adafruit/Adafruit-MAX98357-I2S-Amp-Breakout/Adafruit MAX98357 Breakout - Stereo rev B.brd

## EAGLE design Adafruit MAX98357 Breakout - Stereo rev B.brd (2026-08-27)

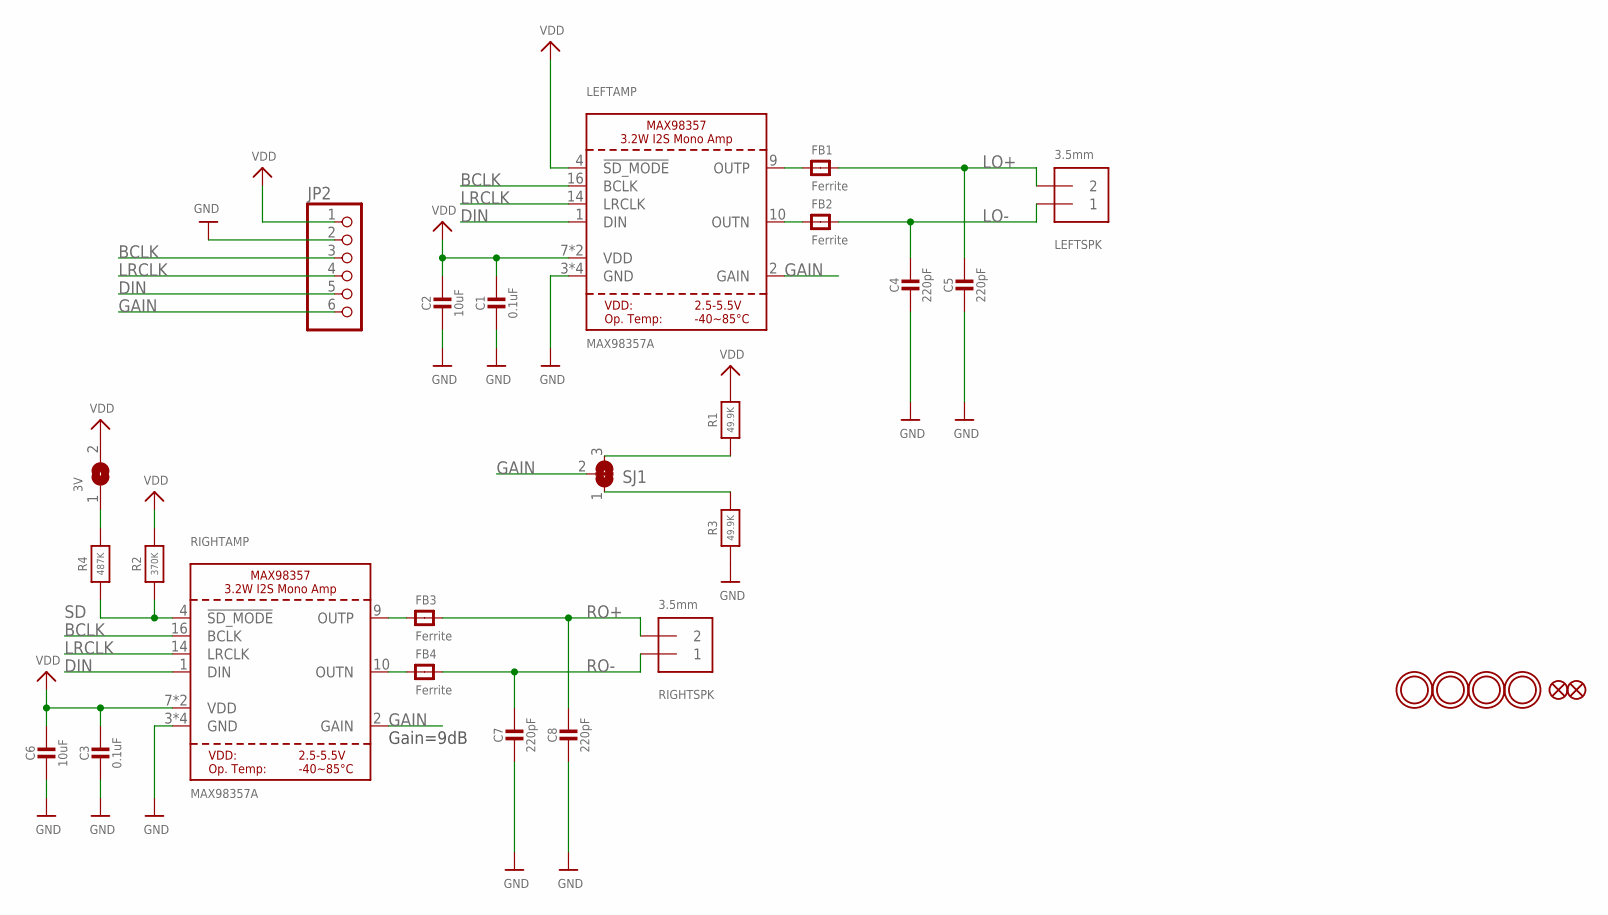
[picture p3: schematic Adafruit MAX98357 Breakout - Stereo rev B.sch]

Parts:
3V: SOLDERJUMPER; SOLDERJUMPER_ARROW_NOPASTE
C1, C3: 0.1uF; 0603-NO
C2, C6: 10uF; 0805-NO
C4, C5, C7, C8: 220pF; 0603-NO
FB1, FB2, FB3, FB4: Ferrite; 0603-NO
FID1, FID2: FIDUCIAL_0.5MM
JP2: HEADER-1X670MIL; 1X06_ROUND_70
LEFTAMP: MAX98357A; QFN16_3MM
LEFTSPK: 3.5mm; TERMBLOCK_1X2-3.5MM
R1, R3: 49.9K; 0603-NO
R2: 370K; 0603-NO
R4: 487K; 0603-NO
RIGHTAMP: MAX98357A; QFN16_3MM
RIGHTSPK: 3.5mm; TERMBLOCK_1X2-3.5MM
SJ1: SOLDERJUMPER_2WAY; SOLDERJUMPER_2WAY_OPEN_NOPASTE
U$9, U$10, U$23, U$24: MOUNTINGHOLE2.5; MOUNTINGHOLE_2.5_PLATED

Connections:
BCLK: JP2.3, LEFTAMP.16 (BCLK), RIGHTAMP.16 (BCLK)
DIN: JP2.5, LEFTAMP.1 (DIN), RIGHTAMP.1 (DIN)
GAIN: JP2.6, LEFTAMP.2 (GAIN), RIGHTAMP.2 (GAIN), SJ1.2
GND: C1.2, C2.2, C3.2, C4.2, C5.2, C6.2, C7.2, C8.2, JP2.2, LEFTAMP.3 (GND), LEFTAMP.11 (GND), LEFTAMP.15 (GND), LEFTAMP.THERMAL (GND), R3.1, RIGHTAMP.3 (GND), RIGHTAMP.11 (GND), RIGHTAMP.15 (GND), RIGHTAMP.THERMAL (GND)
LO+: C5.1, FB1.2, LEFTSPK.2
LO-: C4.1, FB2.2, LEFTSPK.1
LRCLK: JP2.4, LEFTAMP.14 (LRCLK), RIGHTAMP.14 (LRCLK)
unnamed: FB4.1, RIGHTAMP.10 (OUTN)
unnamed: FB3.1, RIGHTAMP.9 (OUTP)
unnamed: R3.2, SJ1.1
unnamed: 3V.1, R4.2
unnamed: FB2.1, LEFTAMP.10 (OUTN)
unnamed: FB1.1, LEFTAMP.9 (OUTP)
unnamed: R1.1, SJ1.3
RO+: C8.1, FB3.2, RIGHTSPK.2
RO-: C7.1, FB4.2, RIGHTSPK.1
SD: R2.1, R4.1, RIGHTAMP.4 (!SD_MODE)
VDD: 3V.2, C1.1, C2.1, C3.1, C6.1, JP2.1, LEFTAMP.4 (!SD_MODE), LEFTAMP.7 (VDD), LEFTAMP.8 (VDD), R1.2, R2.2, RIGHTAMP.7 (VDD), RIGHTAMP.8 (VDD)

Notes on the sheet:
Gain=9dB

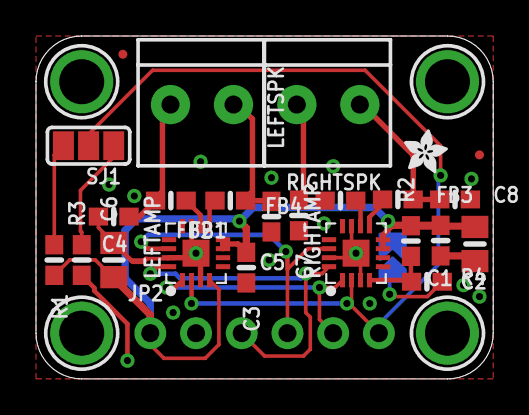
[picture p4: board Adafruit MAX98357 Breakout - Stereo rev B.brd from above]

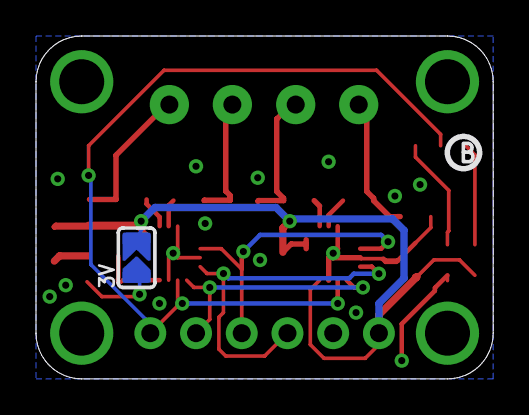
[picture p5: board Adafruit MAX98357 Breakout - Stereo rev B.brd from below]

Board: 2 copper layers, 25.4 x 19.1 mm, 51 parts (6 on the bottom side), 18 nets.

Other parts of the board:
PLABEL0: PLABEL0
PLABEL1: PLABEL1
PLABEL2: PLABEL2
PLABEL3: PLABEL3
PLABEL4: PLABEL4
PLABEL5: PLABEL5
PLABEL6: PLABEL6
PLABEL7: PLABEL7
PLABEL8: PLABEL8
PLABEL9: PLABEL9
PLABEL10: PLABEL10
PLABEL11: PLABEL11
PLABEL12: PLABEL12
PLABEL13: PLABEL13
PLABEL14: PLABEL14
PLABEL15: PLABEL15
PLABEL16: PLABEL16
PLABEL17: PLABEL17
PLABEL18: PLABEL18
PLABEL19: PLABEL19
U$14: ADAFRUIT_2.5MM
U$15: PCBFEAT-REV-040
